jewel-nath/conveysort-arm/docs/report/figures/plot02-joint-angles.tex

% Commanded joint angles over one pick-and-place of a small block, computed by
% replaying firmware/conveyor-sorter: each joint moves 5 PWM counts every 40 ms,
% then the firmware waits 1 s; after step 15 it waits 0.5 s and goes home.
% Computed 2026-10-29; not measured on the arm.
\begin{tikzpicture}
  \begin{axis}[width=14cm, height=7cm, xmin=0, xmax=36, ymin=0, ymax=205,
      xlabel={Time from the command (s)}, ylabel={Commanded angle ($^\circ$)},
      xtick={0,5,10,15,20,25,30,35}, ytick={0,30,60,90,120,150,180},
      grid=major, grid style={hw!80!black, very thin},
      tick label style={font=\scriptsize}, label style={font=\footnotesize},
      legend style={font=\scriptsize, at={(1.02,1)}, anchor=north west, draw=none},
      legend cell align=left]
    \addplot[mcuedge, very thick] coordinates {(0,90) (1.68,90) (3.48,170) (13.68,170) (15.48,90) (35,90)};
    \addlegendentry{base}
    \addplot[hostedge, very thick] coordinates {(0,20) (5.52,20) (7.00,85) (11.88,85) (12.68,50) (19.20,50) (20.32,100) (24.16,100) (25.28,50) (26.78,50) (27.46,20) (35,20)};
    \addlegendentry{shoulder}
    \addplot[uiedge, very thick] coordinates {(0,180) (0.68,150) (17.96,150) (18.20,140) (28.46,140) (29.38,180) (35,180)};
    \addlegendentry{elbow}
    \addplot[visedge, very thick] coordinates {(0,10) (16.48,10) (16.96,30) (31.42,30) (31.90,10) (35,10)};
    \addlegendentry{wrist pitch}
    \addplot[hwedge, very thick, densely dashed] coordinates {(0,90) (35,90)};
    \addlegendentry{wrist roll}
    \addplot[warnedge, very thick] coordinates {(0,120) (10.08,120) (10.88,155) (22.36,155) (23.16,120) (35,120)};
    \addlegendentry{gripper}
    % phases
    \draw[hwedge, densely dotted] (axis cs:10.08,0) -- (axis cs:10.08,205);
    \draw[hwedge, densely dotted] (axis cs:13.68,0) -- (axis cs:13.68,205);
    \draw[hwedge, densely dotted] (axis cs:24.16,0) -- (axis cs:24.16,205);
    \node[font=\scriptsize, anchor=north] at (axis cs:5,204) {reach};
    \node[font=\scriptsize, anchor=north, align=center] at (axis cs:11.9,204) {grip,\\lift};
    \node[font=\scriptsize, anchor=north] at (axis cs:19,204) {set down};
    \node[font=\scriptsize, anchor=north] at (axis cs:30,204) {return};
  \end{axis}
\end{tikzpicture}
