jewel-nath/conveysort-arm/docs/diagrams/conveysort-arm-roadmap.pdf

an arm that picks the block and sets it down in the place for its size block size in millimetres, from a calibrated camera

sorting by colour and shape as well as size
