jewel-nath/conveysort-arm/src/conveysort_description/meshes/wrist.stl

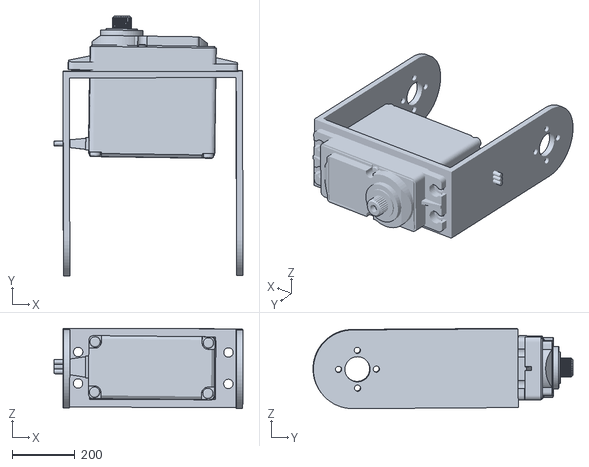
[picture p33: CAD file, 2026-10-24]
src/conveysort_description/meshes/wrist.stl
600.2 x 826.0 x 255.3
