jewel-nath/conveysort-arm/src/conveysort_description/meshes/lower_arm.stl

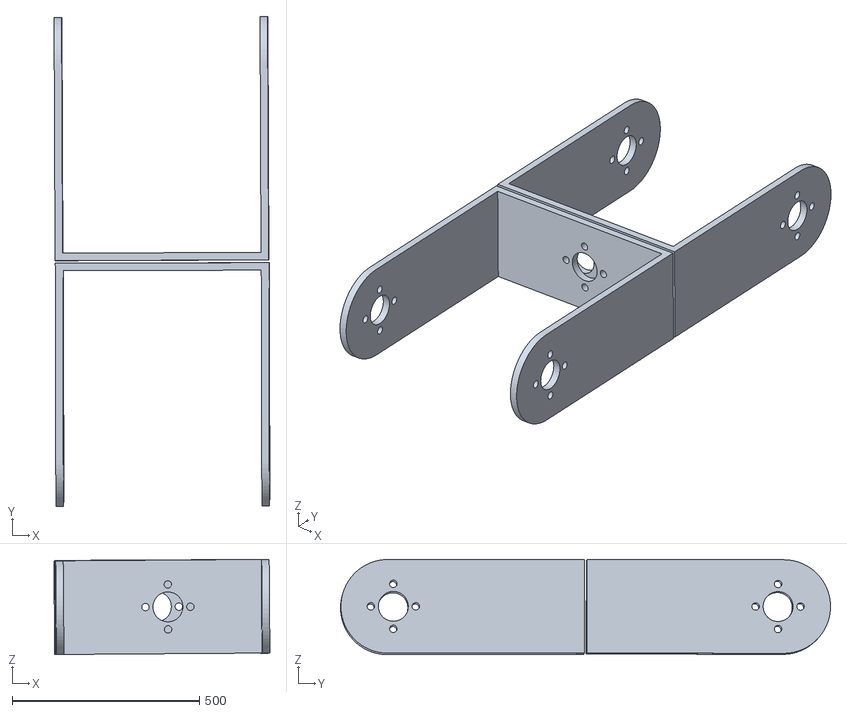
[picture p34: CAD file, 2026-10-24]
src/conveysort_description/meshes/lower_arm.stl
575.9 x 1308.4 x 254.4
