jewel-nath/conveysort-arm/src/conveysort_description/meshes/top_arm.stl

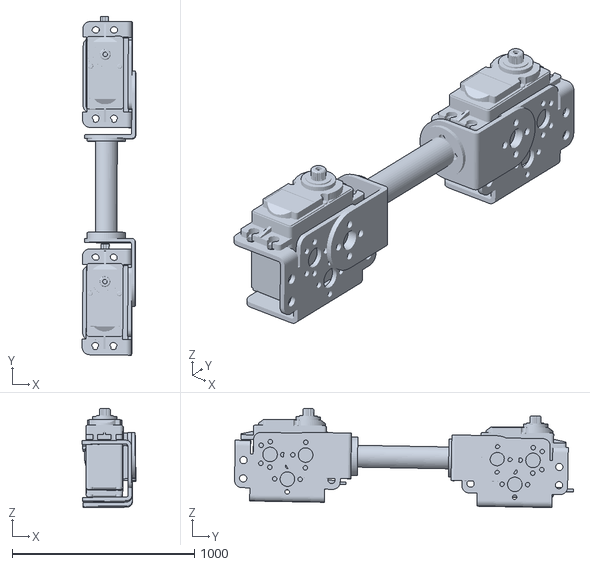
[picture p35: CAD file, 2026-10-24]
src/conveysort_description/meshes/top_arm.stl
294.4 x 1859.4 x 543.6
