jewel-nath/conveysort-arm/src/conveysort_description/meshes/base_cylinder.stl

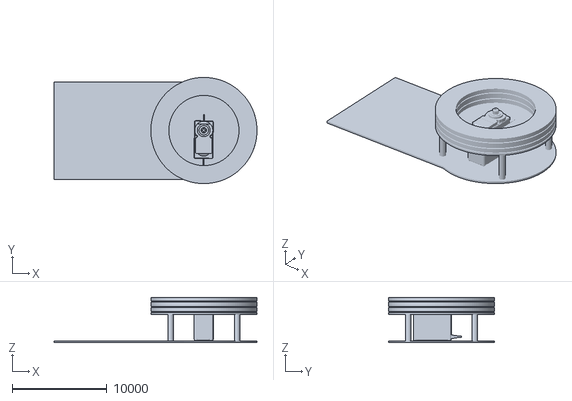
[picture p36: CAD file, 2026-10-24]
src/conveysort_description/meshes/base_cylinder.stl
21419.8 x 11199.4 x 4800.0
