jewel-nath/conveysort-arm/src/conveysort_description/meshes/clawbase.stl

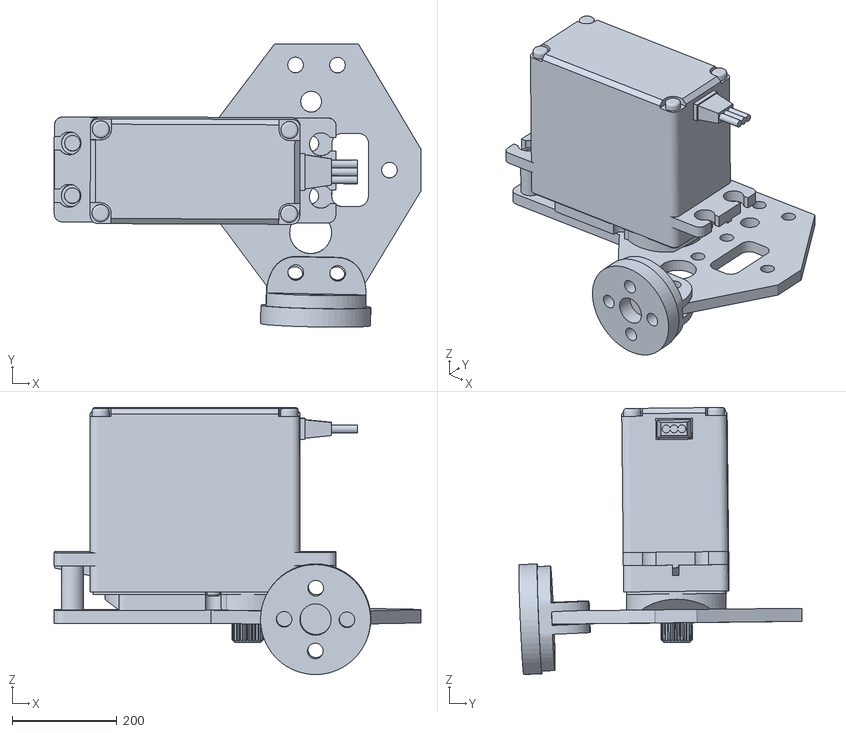
[picture p37: CAD file, 2026-10-24]
src/conveysort_description/meshes/clawbase.stl
700.4 x 540.9 x 509.8
