jewel-nath/conveysort-arm/src/conveysort_description/meshes/clawl.stl

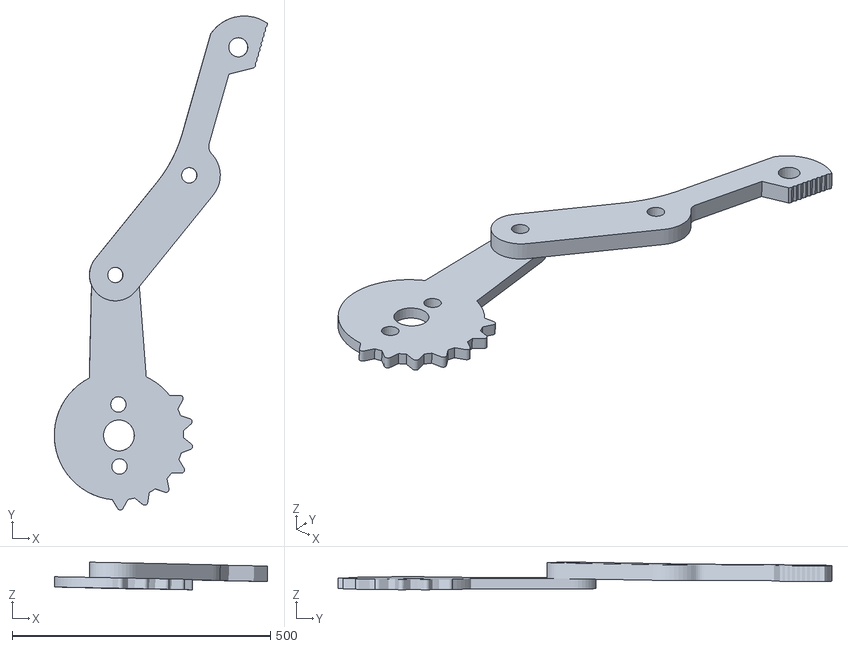
[picture p38: CAD file, 2026-10-24]
src/conveysort_description/meshes/clawl.stl
413.2 x 956.1 x 53.6
