jewel-nath/conveysort-arm/src/conveysort_description/meshes/top_plate.stl

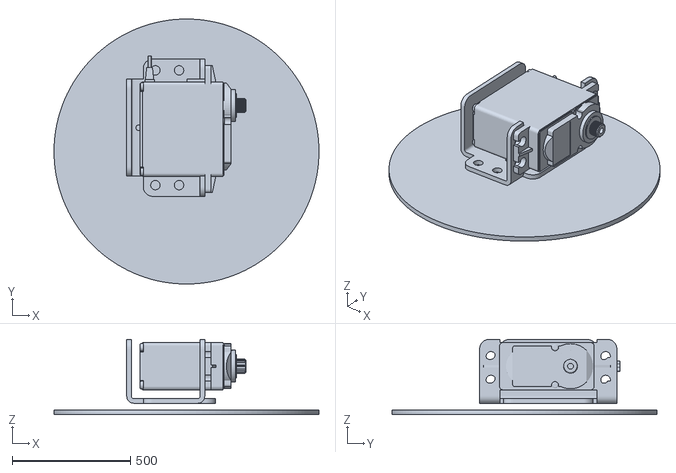
[picture p39: CAD file, 2026-10-24]
src/conveysort_description/meshes/top_plate.stl
1119.9 x 1119.8 x 317.9
