jewel-nath/conveysort-arm/src/conveysort_description/meshes/clawr.stl

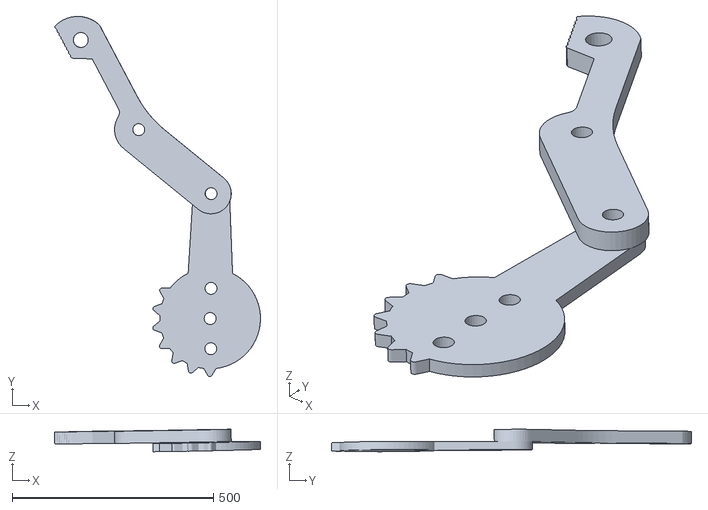
[picture p40: CAD file, 2026-10-24]
src/conveysort_description/meshes/clawr.stl
512.1 x 895.4 x 56.1
