jewel-nath/conveysort-arm/docs/diagrams/conveysort-arm-system-overview.pdf

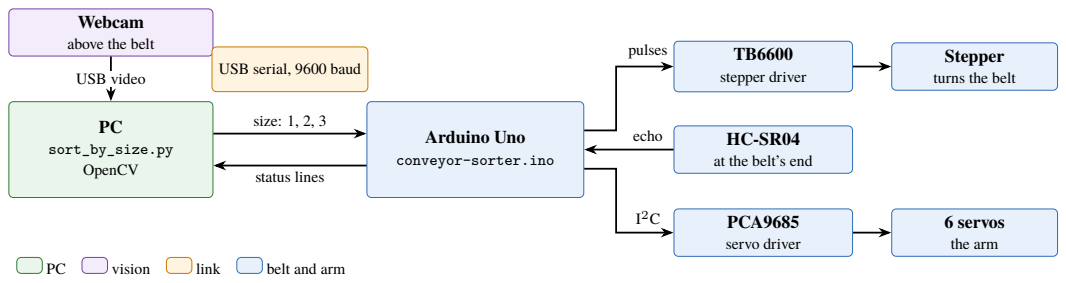
[picture p41: page 1]
PC sort_by_size.py OpenCV; USB video; size: 1, 2, 3; status lines; TB6600 stepper driver; PCA9685 servo driver; 6 servos the arm; pulses; echo; vision; link; belt and arm

Webcam
above the belt

Stepper
turns the belt

USB serial, 9600 baud

Arduino Uno
conveyor-sorter.ino

at the belt’s end
