jewel-nath/conveysort-arm/docs/diagrams/conveysort-arm-decision-logic.pdf

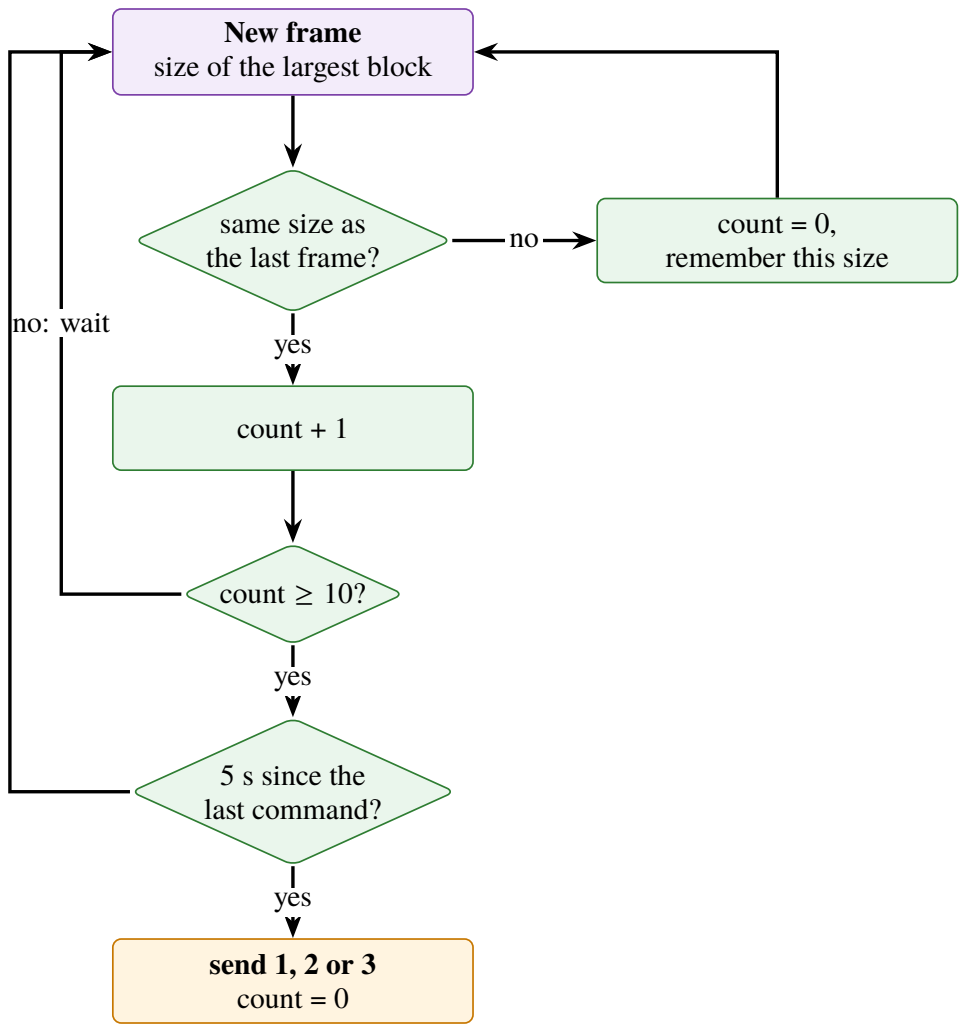
[picture p42: page 1]
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

New frame
size of the largest block

same size as
the last frame?

count = 0,
remember this size

no: | wait

yes
