jewel-nath/conveysort-arm/docs/diagrams/conveysort-arm-ros2-packages.pdf

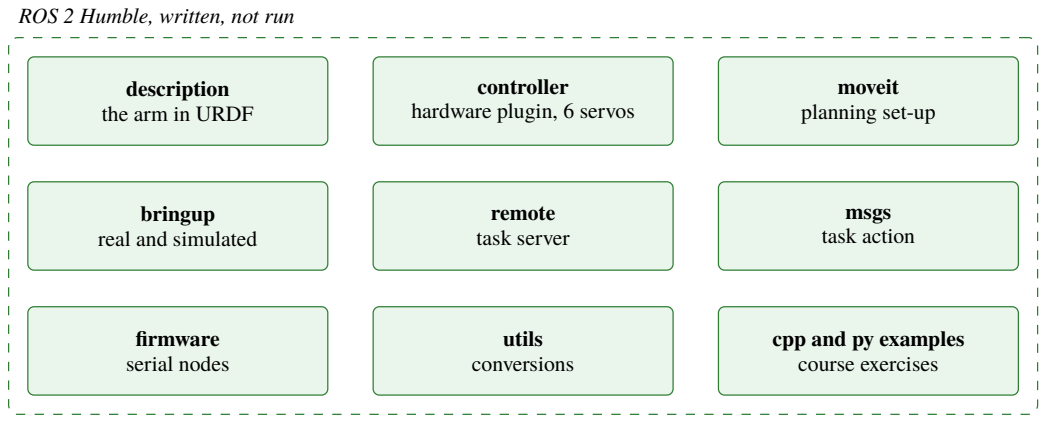
[picture p43: page 1]
controller; remote task server; msgs task action; firmware serial nodes; utils conversions

ROS 2 Humble, written, not run

description
the arm in URDF

moveit
planning set-up

hardware plugin, 6 servos

bringup
real and simulated

cpp and py examples
course exercises
