jewel-nath/conveysort-arm/docs/diagrams/conveysort-arm-timeline.pdf

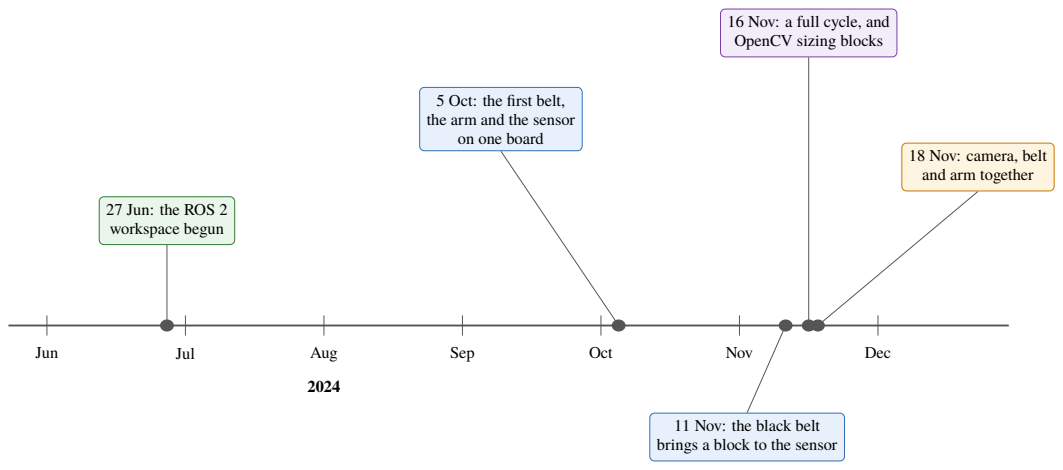
[picture p44: page 1]
Jun; Jul; Aug; Sep; Oct; Nov; Dec

16 Nov: a full cycle, and
OpenCV sizing blocks

5 Oct: the first belt,
the arm and the sensor
on one board

18 Nov: camera, belt
and arm together

27 Jun: the ROS 2
workspace begun

11 Nov: the black belt
brings a block to the sensor
