jewel-nath/conveysort-arm/docs/diagrams/conveysort-arm-vision-pipeline.pdf

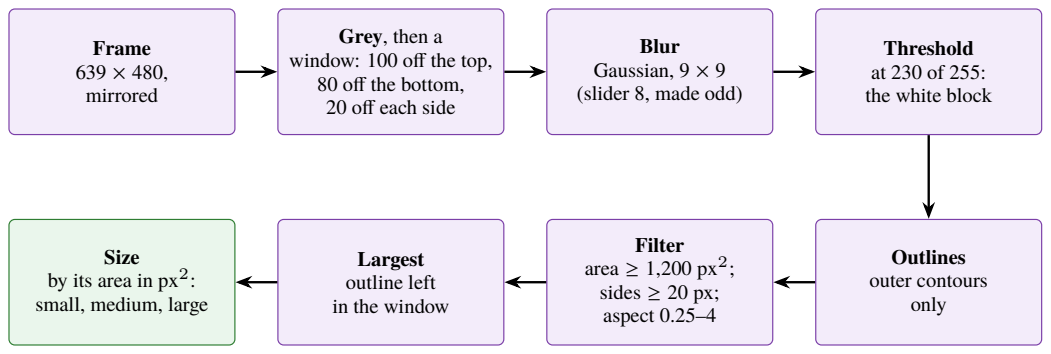
[picture p45: page 1]
Frame 639 × 480, mirrored; Outlines outer contours only; Filter area ≥ 1,200 px²; sides ≥ 20 px; aspect 0.25–4

Grey, then a
window: 100 off the top,
80 off the bottom,
20 off each side

Blur
Gaussian, 9 × 9
(slider 8, made odd)

Threshold
the white block

Size
by its area in px²
small, medium, large

Largest
outline left
in the window
