jewel-nath/conveysort-arm/firmware/ros2-robot-control/ros2-robot-control.ino

// Based on the arduinobot code from Antonio Brandi's course "Robotics and ROS 2 - Learn by Doing!
// Manipulators": https://github.com/AntoBrandi/Robotics-and-ROS-2-Learn-by-Doing-Manipulators
// Licensed under the Apache License 2.0 (LICENSE-APACHE). Changed for ConveySort-Arm: the names,
// and in some files the arm's joints and servos.

#include <Servo.h>

// Declare the Arduino pin where each servo is connected
#define SERVO_BASE_PIN 8
#define SERVO_SHOULDER_PIN 9
#define SERVO_ELBOW_PIN 10
#define SERVO_WRISTE_PITCH_PIN 11
#define SERVO_WRISTE_ROLL_PIN 12
#define SERVO_GRIPPER_PIN 7

// Define the start configuration of the joints
#define BASE_START 90
#define SHOULDER_START 90
#define ELBOW_START 90
#define WRISTE_PITCH_START 90
#define WRISTE_ROLL_START 90
#define GRIPPER_START 0

// Register the servo motors of each joint
Servo base;  
Servo shoulder;  
Servo elbow;  
Servo wriste_pitch;
Servo wriste_roll;
Servo gripper; 

uint8_t idx = 0;
uint8_t val_idx = 0;
char value[4] = "000";


/*
 * This function moves a given servo smoothly from a given start position to a given end position.
 * The movement can be both clockwise or counterclockwise based on the values assigned to
 * the start position and end position
 */
void reach_goal(Servo& motor, int goal){
  if(goal>=motor.read()){
    // goes from the start point degrees to the end point degrees
    for (int pos = motor.read(); pos <= goal; pos += 1) { 
      motor.write(pos);     
      delay(5);                       
    }
  } else{
    // goes from the end point degrees to the start point degrees
    for (int pos = motor.read(); pos >= goal; pos -= 1) { 
      motor.write(pos);     
      delay(5);                       
    }
  }
}

void setup() {
  // Attach and Initialize each Servo to the Arduino pin where it is connected
  base.attach(SERVO_BASE_PIN);
  shoulder.attach(SERVO_SHOULDER_PIN);
  elbow.attach(SERVO_ELBOW_PIN);
  wriste_pitch.attach(SERVO_WRISTE_PITCH_PIN);
  wriste_roll.attach(SERVO_WRISTE_ROLL_PIN);
  gripper.attach(SERVO_GRIPPER_PIN); 

  // Set a common start point for each joint
  // This way, the start status of each joint is known
  base.write(BASE_START);
  shoulder.write(SHOULDER_START);
  elbow.write(ELBOW_START);
  wriste_pitch.write(WRISTE_PITCH_START);
  wriste_roll.write(WRISTE_ROLL_START);
  gripper.write(GRIPPER_START);

  // Start the Serial communication with ROS
  Serial.begin(115200);
  Serial.setTimeout(1);
}

void loop() {
  if (Serial.available())
  {
    char chr = Serial.read();

    // base motor
    if(chr == 'b')
    {
      idx = 0;
      val_idx = 0;
    }
    // shoulder motor
    else if(chr == 's')
    {
      idx = 1;
      val_idx = 0;
    }
    // elbow motor
    else if(chr == 'e')
    {
      idx = 2;
      val_idx = 0;
    }
    //wriste_pitch motor 
    else if(chr == 'w')
    {
      idx = 3;
      val_idx = 0;
    }
    //wriste_roll motor 
    else if(chr == 'r')
    {
      idx = 4;
      val_idx = 0;
    }
    // gripper motor
    else if(chr == 'g')
    {
      idx = 5;
      val_idx = 0;
    }
    // Separator
    else if(chr == ',')
    {
      int val = atoi(value);
      if(idx == 0)
      {
        reach_goal(base, val);
      }
      else if(idx == 1)
      {
        reach_goal(shoulder, val);
      }
      else if(idx == 2)
      {
        reach_goal(elbow, val);
      }
      else if(idx == 3)
      {
        reach_goal(wriste_pitch, val);
      }
      else if(idx == 4)
      {
        reach_goal(wriste_roll, val);
      }
      else if(idx == 5)
      {
        reach_goal(gripper, val);
      }

      // reset the angle
      value[0] = '0';
      value[1] = '0';
      value[2] = '0';
      value[3] = '\0';
    }
    // Plain number
    else
    {
      value[val_idx] = chr;
      val_idx++;
    }
  }
}
