jewel-nath/conveysort-arm/src/conveysort_moveit/config/joint_limits.yaml

# Based on the arduinobot code from Antonio Brandi's course "Robotics and ROS 2 - Learn by Doing!
# Manipulators": https://github.com/AntoBrandi/Robotics-and-ROS-2-Learn-by-Doing-Manipulators
# Licensed under the Apache License 2.0 (LICENSE-APACHE). Changed for ConveySort-Arm: the names,
# and in some files the arm's joints and servos.

# joint_limits.yaml allows the dynamics properties specified in the URDF to be overwritten or augmented as needed

# For beginners, we downscale velocity and acceleration limits.
# You can always specify higher scaling factors (<= 1.0) in your motion requests.  # Increase the values below to 1.0 to always move at maximum speed.
default_velocity_scaling_factor: 0.1
default_acceleration_scaling_factor: 0.1

# Specific joint properties can be changed with the keys [max_position, min_position, max_velocity, max_acceleration]
# Joint limits can be turned off with [has_velocity_limits, has_acceleration_limits]
joint_limits:
  joint_1:
    has_velocity_limits: true
    max_velocity: 10.0
    has_acceleration_limits: true
    max_acceleration: 5.0
  joint_2:
    has_velocity_limits: true
    max_velocity: 10.0
    has_acceleration_limits: true
    max_acceleration: 5.0
  joint_3:
    has_velocity_limits: true
    max_velocity: 10.0
    has_acceleration_limits: true
    max_acceleration: 5.0
  joint_4:
    has_velocity_limits: true
    max_velocity: 10.0
    has_acceleration_limits: true
    max_acceleration: 5.0
  joint_5:
    has_velocity_limits: true
    max_velocity: 10.0
    has_acceleration_limits: true
    max_acceleration: 5.0
  joint_6:
    has_velocity_limits: true
    max_velocity: 10.0
    has_acceleration_limits: true
    max_acceleration: 5.0
  joint_7:
    has_velocity_limits: true
    max_velocity: 10.0
    has_acceleration_limits: true
    max_acceleration: 5.0
