jewel-nath/conveysort-arm/experiments/esp32-phone-control/secrets.example.h

// Copy this file to secrets.h, next to the sketch, and choose your own password before flashing.
// secrets.h is in .gitignore, so the password stays out of the repository.
// WPA2 needs a password of at least 8 characters.
#pragma once

#define AP_SSID "Robotics Arm"
#define AP_PASSWORD "choose-a-password"
