jewel-nath/conveysort-arm/(commit log)

2026-10-24 Move files into a standard layout
    Rename the ROS 2 packages from armbot_* to conveysort_*, move the
    sorter's Python into src/vision/, its sketch into firmware/, and the
    tests and course sketches into experiments/. Only moves: no file
    changes, so each file keeps its history.
    [base_cylinder.stl, clawbase.stl, clawl.stl, clawr.stl, conveysort_arm.urdf.xacro, conveysort_arm_controllers.yaml, conveysort_arm_gazebo.xacro, conveysort_arm_ros2_control.xacro]
2026-10-24 Update names, credits and the README for the new layout
    - Rename armbot to conveysort inside the files, so the package names,
    the robot's name and the paths match the new folders.
    - Credit the borrowed code: Antonio Brandi's course (Apache-2.0, with
    LICENSE-APACHE and a notice in each file), Ujwal Nandanwar's ESP32
    sketch (MIT) and the ROS 2 docs' dev container guide (CC BY 4.0).
    - Read the ESP32 access point's password from a git-ignored secrets.h.
    - Use the GitHub noreply address as maintainer, and Apache-2.0 as the
    licence name in every package.
    - Remove three meshes nothing uses.
    - Put run-container.sh's shebang on its first line; keep the executable
    bit on shell scripts only.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
    [base_cylinder_mesh.stl, conveysort_arm.urdf.xacro, conveysort_arm_controllers.yaml, conveysort_arm_gazebo.xacro, conveysort_arm_ros2_control.xacro, joint_limits.yaml]
2026-10-28 Add a technical report on ConveySort-Arm, its diagrams, and show them in the README
